oskitone/space_dice/(notices)

Notices in the files:
kicad/space_dice.kicad_pcb:
CC BY-SA 4.0
